AlfredoSystems/NoU3-Hardware/3dmodels/ESP32-S3-MINI-1.step

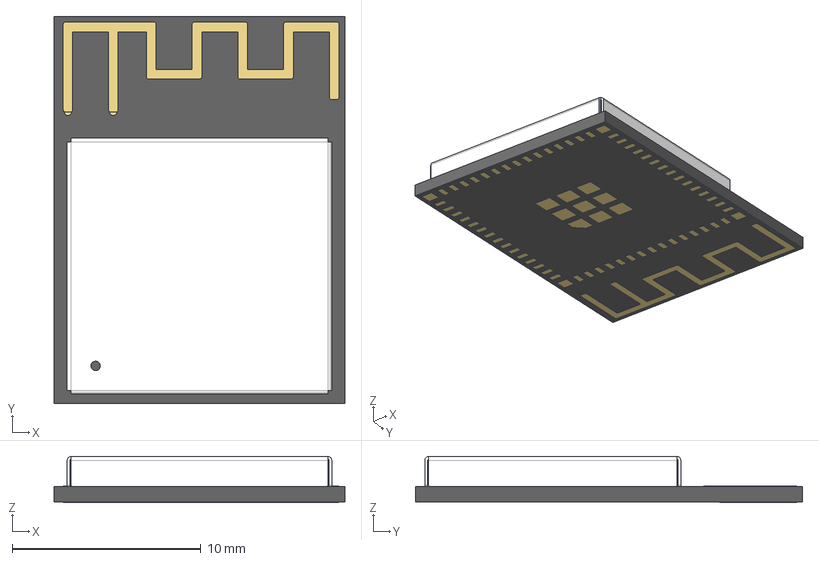
[picture p1: CAD file, 2026-11-02]
3dmodels/ESP32-S3-MINI-1.step
15.4 x 20.5 x 2.44 mm
uid__2489
C0201_20210301.xtd x 14
L0201_20210301.xtd x 3
R0201_20210301.xtd x 3
C0402_20210301.xtd
ESP32-S3_20210301.xtd
DFN1006.xtd
XTAL3225_20210301.xtd
Imported
MINI-ANT-TYPE-S-H_t
MINI-ANT-TYPE-S-H_b
ESP32-S3-S2-MINI-solder_pad
ShieldBox_ESP32-S2-MINI-1_V1.1_20231127
