AlfredoSystems/NoU3-Hardware/NoU3-Media/NoU3.pdf

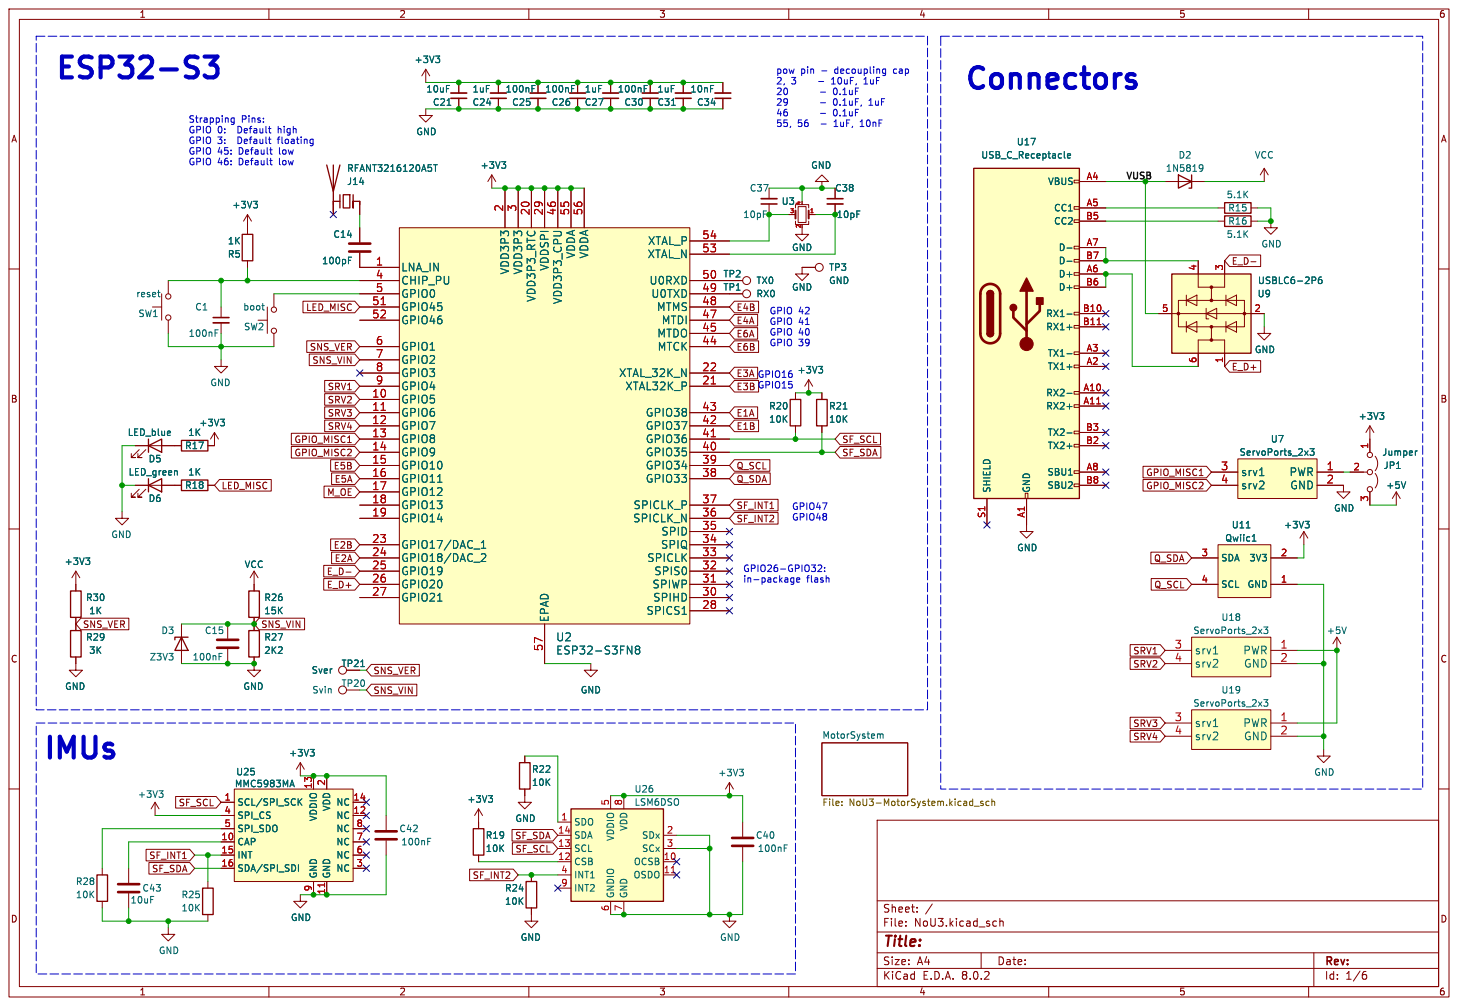
[picture p2: page 1]

3 SPIHD 30 SPIWP 31 SPIS0 32 SPICLK 33 SPIQ 34 SPID 35 SPICLK_N 36 SPICLK_P 37 GPIO33 38 GPIO34 39 CHIP_PU 4 GPIO35 40 GPIO36 41 GPIO37 42 GPIO38 43 MTCK 44 MTDO 45 VDD3P3_CPU 46 MTDI 47 MTMS 48 U0TXD 49 GPIO0 5 U0RXD 50 GPIO45 51 GPIO46 52 XTAL_N 53 XTAL_P 54 VDDA 55 VDDA 56 EPAD 57 GPIO1 6 GPIO2 7 GPIO3 8 GPIO4 9 C14

3 SPIHD 30 SPIWP 31 SPIS0 32 SPICLK 33 SPIQ 34 SPID 35 SPICLK_N 36 SPICLK_P 37 GPIO33 38 GPIO34 39 CHIP_PU 4 GPIO35 40 GPIO36 41 GPIO37 42 GPIO38 43 MTCK 44 MTDO 45 VDD3P3_CPU 46 MTDI 47 MTMS 48 U0TXD 49 GPIO0 5 U0RXD 50 GPIO45 51 GPIO46 52 XTAL_N 53 XTAL_P 54 VDDA 55 VDDA 56 EPAD 57 GPIO1 6 GPIO2 7 GPIO3 8 GPIO4 9 U2ESP32-S3FN8

put buttons in better spot GPIO26-GPIO32:

Id: 1/6 Title: File: NoU3.kicad_sch Sheet: / MotorSystem

2 NC 3 SPI_CS 4 SPI_SDO 5 NC 6 NC 7 NC 8 GND

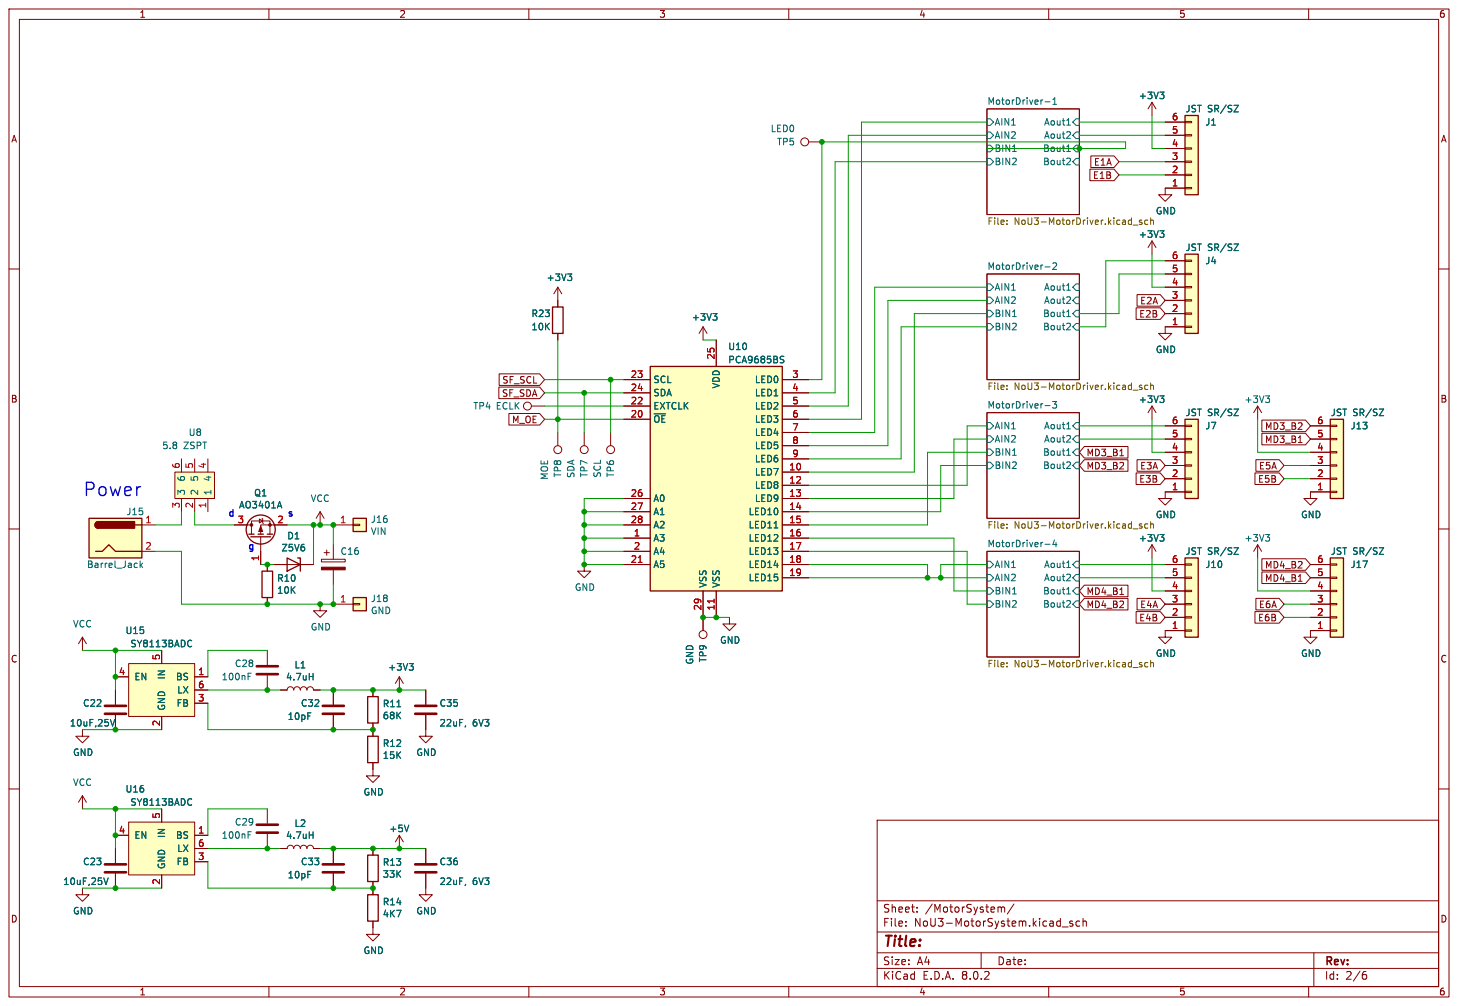
[picture p3: page 2]

JST SR/SZ SDA TP7 R23

JST SR/SZ GND GND

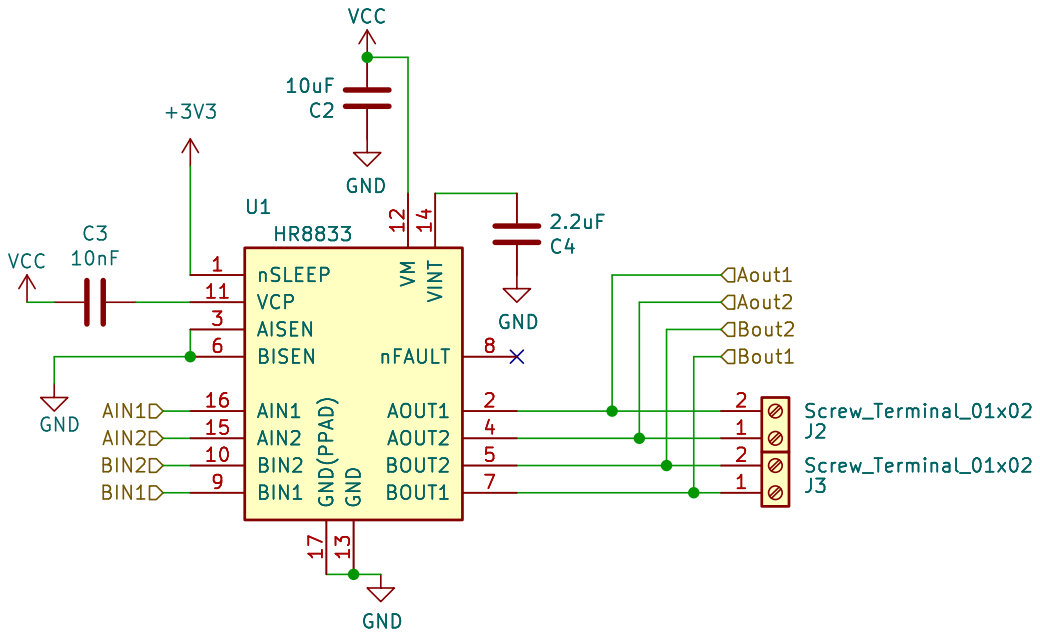
[picture p4: page 3]

1 1
2 2

Id: 3/6 Title: File: NoU3-MotorDriver.kicad_sch Sheet: /MotorSystem/MotorDriver-1/

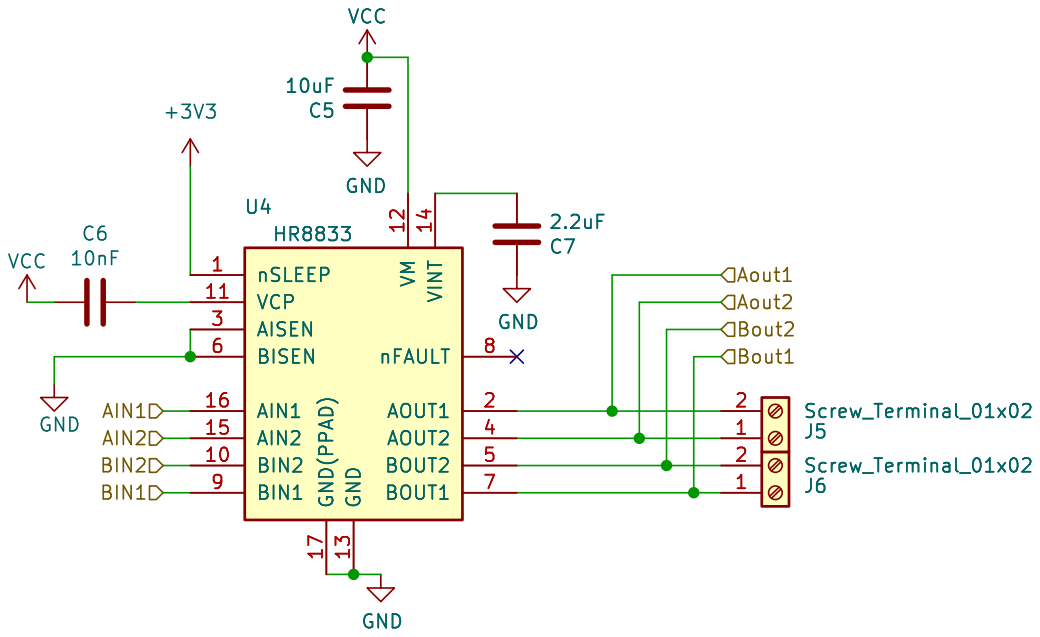
[picture p5: page 4]

1 1
2 2

Id: 4/6 Title: File: NoU3-MotorDriver.kicad_sch Sheet: /MotorSystem/MotorDriver-2/

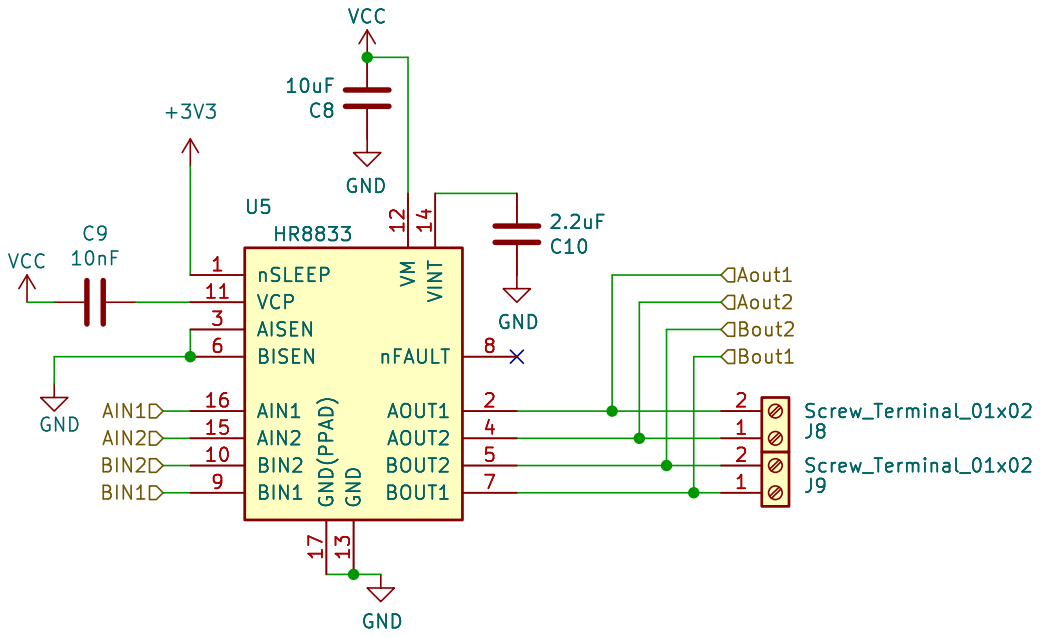
[picture p6: page 5]

1 1
2 2

Id: 5/6 Title: File: NoU3-MotorDriver.kicad_sch Sheet: /MotorSystem/MotorDriver-3/

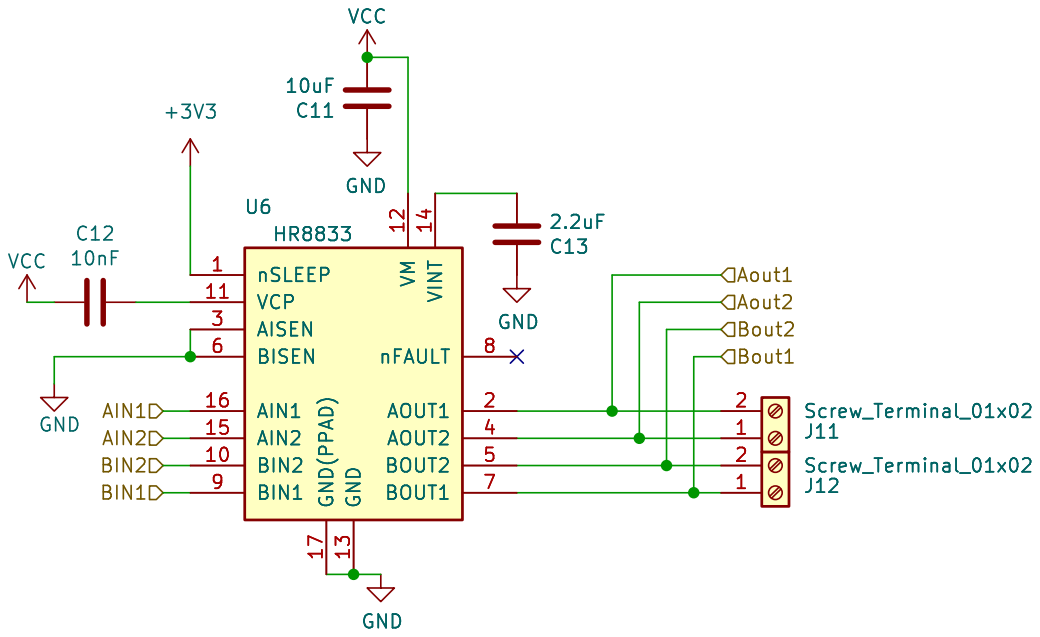
[picture p7: page 6]

1 1
2 2

Id: 6/6 Title: File: NoU3-MotorDriver.kicad_sch Sheet: /MotorSystem/MotorDriver-4/
