AlfredoSystems/NoU3-Hardware/(commit log)

2023-03-30 NoU3 initial commit and first board revision
    [NoU3-MotorDriver.kicad_sch, NoU3.kicad_pcb, NoU3.kicad_sch]
2023-07-27 locked in mag and 6dof sensor for this rev
    [NoU3.kicad_sch]
2023-07-27 vin sns and version sns dividers
    [NoU3.kicad_sch]
2023-07-29 finished main changes, just need to route now
    [NoU3-MotorDriver.kicad_sch, NoU3.kicad_pcb, NoU3.kicad_sch]
2023-07-30 routing half finished
    [NoU3.kicad_pcb, NoU3.kicad_sch]
2023-07-30 finished routing, ran DRC, fixed all the important DRC errors
    [NoU3.kicad_pcb, NoU3.kicad_sch]
2023-08-09 NoU3 as ordered 8/7/23
    [BOM-NoU3.csv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]
2023-10-09 updated date
    [NoU3.kicad_pcb]
2023-12-11 added jst CAD
    [BM06B-SRSS-TB.STEP, NoU3.kicad_pcb, NoU3.kicad_sch]
2024-04-27 updated todo
    [NoU3.kicad_sch]
2024-05-06 updated notes
    [NoU3.kicad_sch]
2024-05-15 initial V3.2 changes
    [NoU3-MotorDriver.kicad_sch, NoU3.kicad_pcb, NoU3.kicad_sch]
2024-05-16 order candidate, layout complete
    [NoU3-MotorDriver.kicad_sch, NoU3.kicad_pcb, NoU3.kicad_sch]
2024-05-30 used a different fabrication tool
    [BOM-NoU3.csv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]
2024-07-02 Ordered NoU3.3 and 3.4 lite
    [BM06B-SRSS-TB.STEP, NoU3-Lite-MotorDriver.kicad_sch, NoU3-Lite.kicad_pcb, NoU3-Lite.kicad_sch, NoU3.kicad_pcb, NoU3.kicad_sch, bom.csv, designators.csv]
2024-08-16 rule and schematic tweaks
    [NoU3.kicad_pcb]
2024-10-03 Schematic cleanup and plotted PDF
    [NoU3-MotorDriver.kicad_sch, NoU3-MotorSystem.kicad_sch, NoU3.kicad_pcb, NoU3.kicad_sch]
2025-04-03 updated labels
    [NoU3-MotorDriver.kicad_sch, NoU3-MotorSystem.kicad_sch, NoU3.kicad_pcb, bom.csv]
2025-04-10 commit before updating to kicad 9
    [NoU3.kicad_pcb, bom.csv, designators.csv, positions.csv]
2025-04-10 updated for kicad 9
    [NoU3-MotorDriver.kicad_sch, NoU3-MotorSystem.kicad_sch, NoU3.kicad_sch]
2025-04-28 panalized for latest order
    [NoU3.kicad_pcb, bom.csv, designators.csv, positions.csv]
2025-07-18 Update wiring and remove unused junctions in schematic
    [NoU3-MotorSystem.kicad_sch]
2025-10-22 first commit for V3.4 changes
    [NoU3.kicad_pcb, NoU3.kicad_sch]
2025-11-05 bumped version to NoU3.5
    [NoU3-MotorSystem.kicad_sch, NoU3.kicad_pcb, NoU3.kicad_sch, bom.csv, designators.csv, positions.csv]
2025-11-05 removed mag sensor, improved regulator resistor values
    [NoU3-MotorSystem.kicad_sch, NoU3.kicad_pcb, NoU3.kicad_sch]
2025-11-06 added 7th encoder, 2nd 220uf cap
    [NoU3-MotorSystem.kicad_sch, NoU3.kicad_pcb, NoU3.kicad_sch, bom.csv, designators.csv, positions.csv]
2025-11-06 NoU3.5s as ordered 11/6/25
    [NoU3-MotorSystem.kicad_sch, NoU3.kicad_pcb, NoU3.kicad_sch, bom.csv, designators.csv, positions.csv]
2025-11-25 first commit for NoU3.6
    [NoU3.kicad_pcb, NoU3.kicad_sch]
2025-11-26 Update LSM6DS3TR-C part and add PCB silk circle
    Changed the schematic part value, datasheet, and LCSC code from LSM6DSDTR to LSM6DS3TR-C. Added a new circle to the F.SilkS layer in the PCB. Removed the auto-saved files reference.
    [NoU3.kicad_pcb, NoU3.kicad_sch]
2025-11-26 Fixed polarity convention for encoder port 1
    [NoU3.kicad_pcb]
2025-12-02 Swap positions of MD2_A1 and MD2_A2 labels
    [NoU3-MotorSystem.kicad_sch]
2026-03-25 Adjust component positions, silkscreen and traces
    [NoU3.kicad_pcb, NoU3.kicad_sch]
2026-07-22 Updated to KiCAD 10.0
    [NoU3-MotorDriver.kicad_sch, NoU3-MotorSystem.kicad_sch, NoU3.kicad_pcb, NoU3.kicad_sch]
2026-09-29 Update .gitignore and untrack lock files and fab backups
    Ignore KiCad local history (.history/), lock files (*.lck), fab plugin backup zips (production*/backups/) and OS junk. Fix the #auto_saved_files# rule, which git was reading as a comment.
2026-10-20 updated footprints
2026-10-21 cleaned up JSTs on motor driver sheet
2026-10-21 Reroute PCB connections and adjust DRC rules
    Add and revise PCB routing for several connector and component nets, including repositioning U9. Ignore silkscreen clearance and overlap violations, and update schematic notes.
2026-10-23 PY32F030K28U6TR motor controller chip
2026-10-29 motor driver footprints
2026-11-02 switch to ESP32-S3-MINI
2026-11-11 trace width and via fixes for current levels
