AlfredoSystems/NoU3-Hardware/NoU3.kicad_pcb

## KiCad design NoU3.kicad_pcb (2026-11-11)

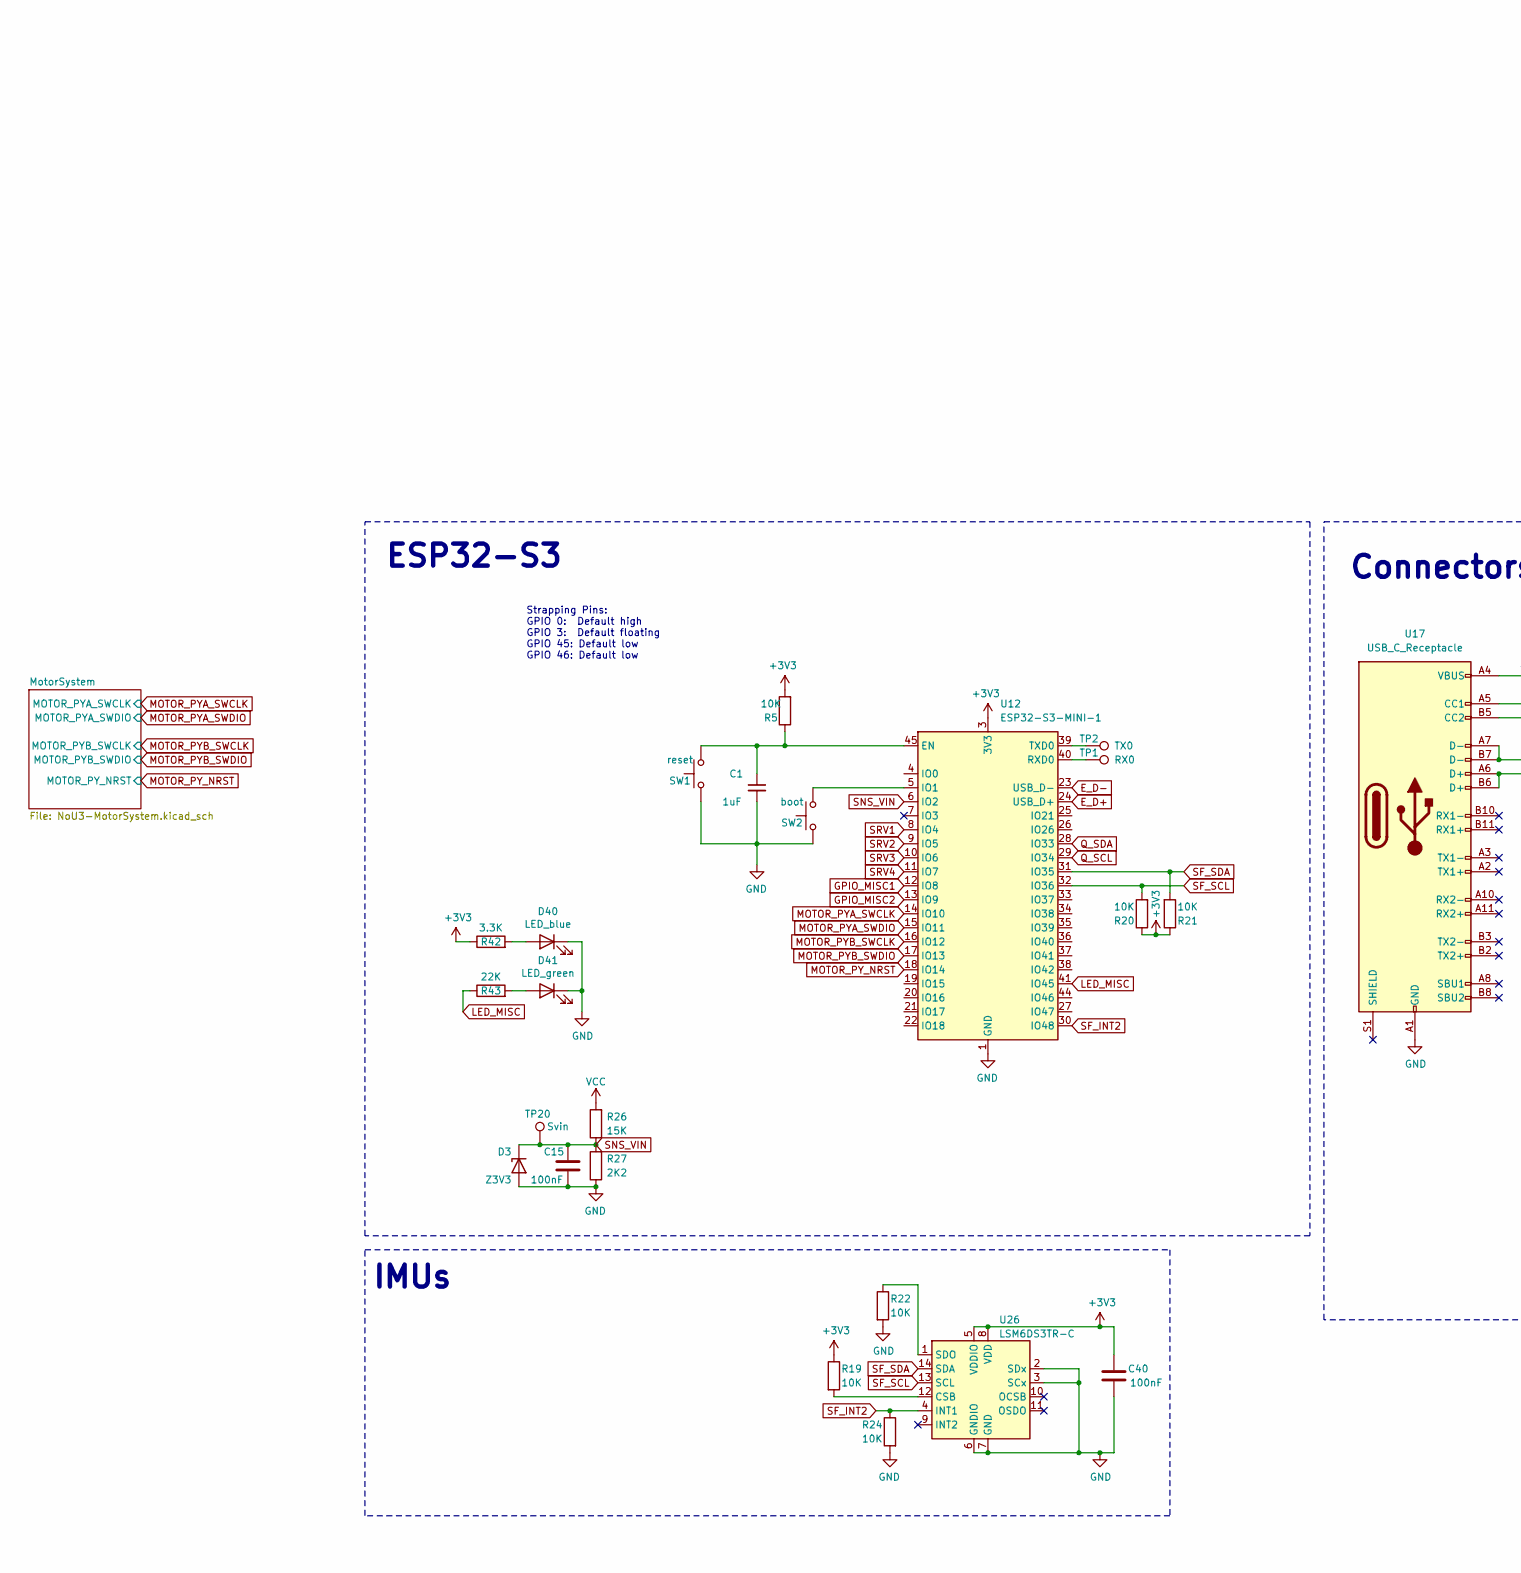
[picture p1: schematic NoU3.kicad_sch, part in row 1, column 1]

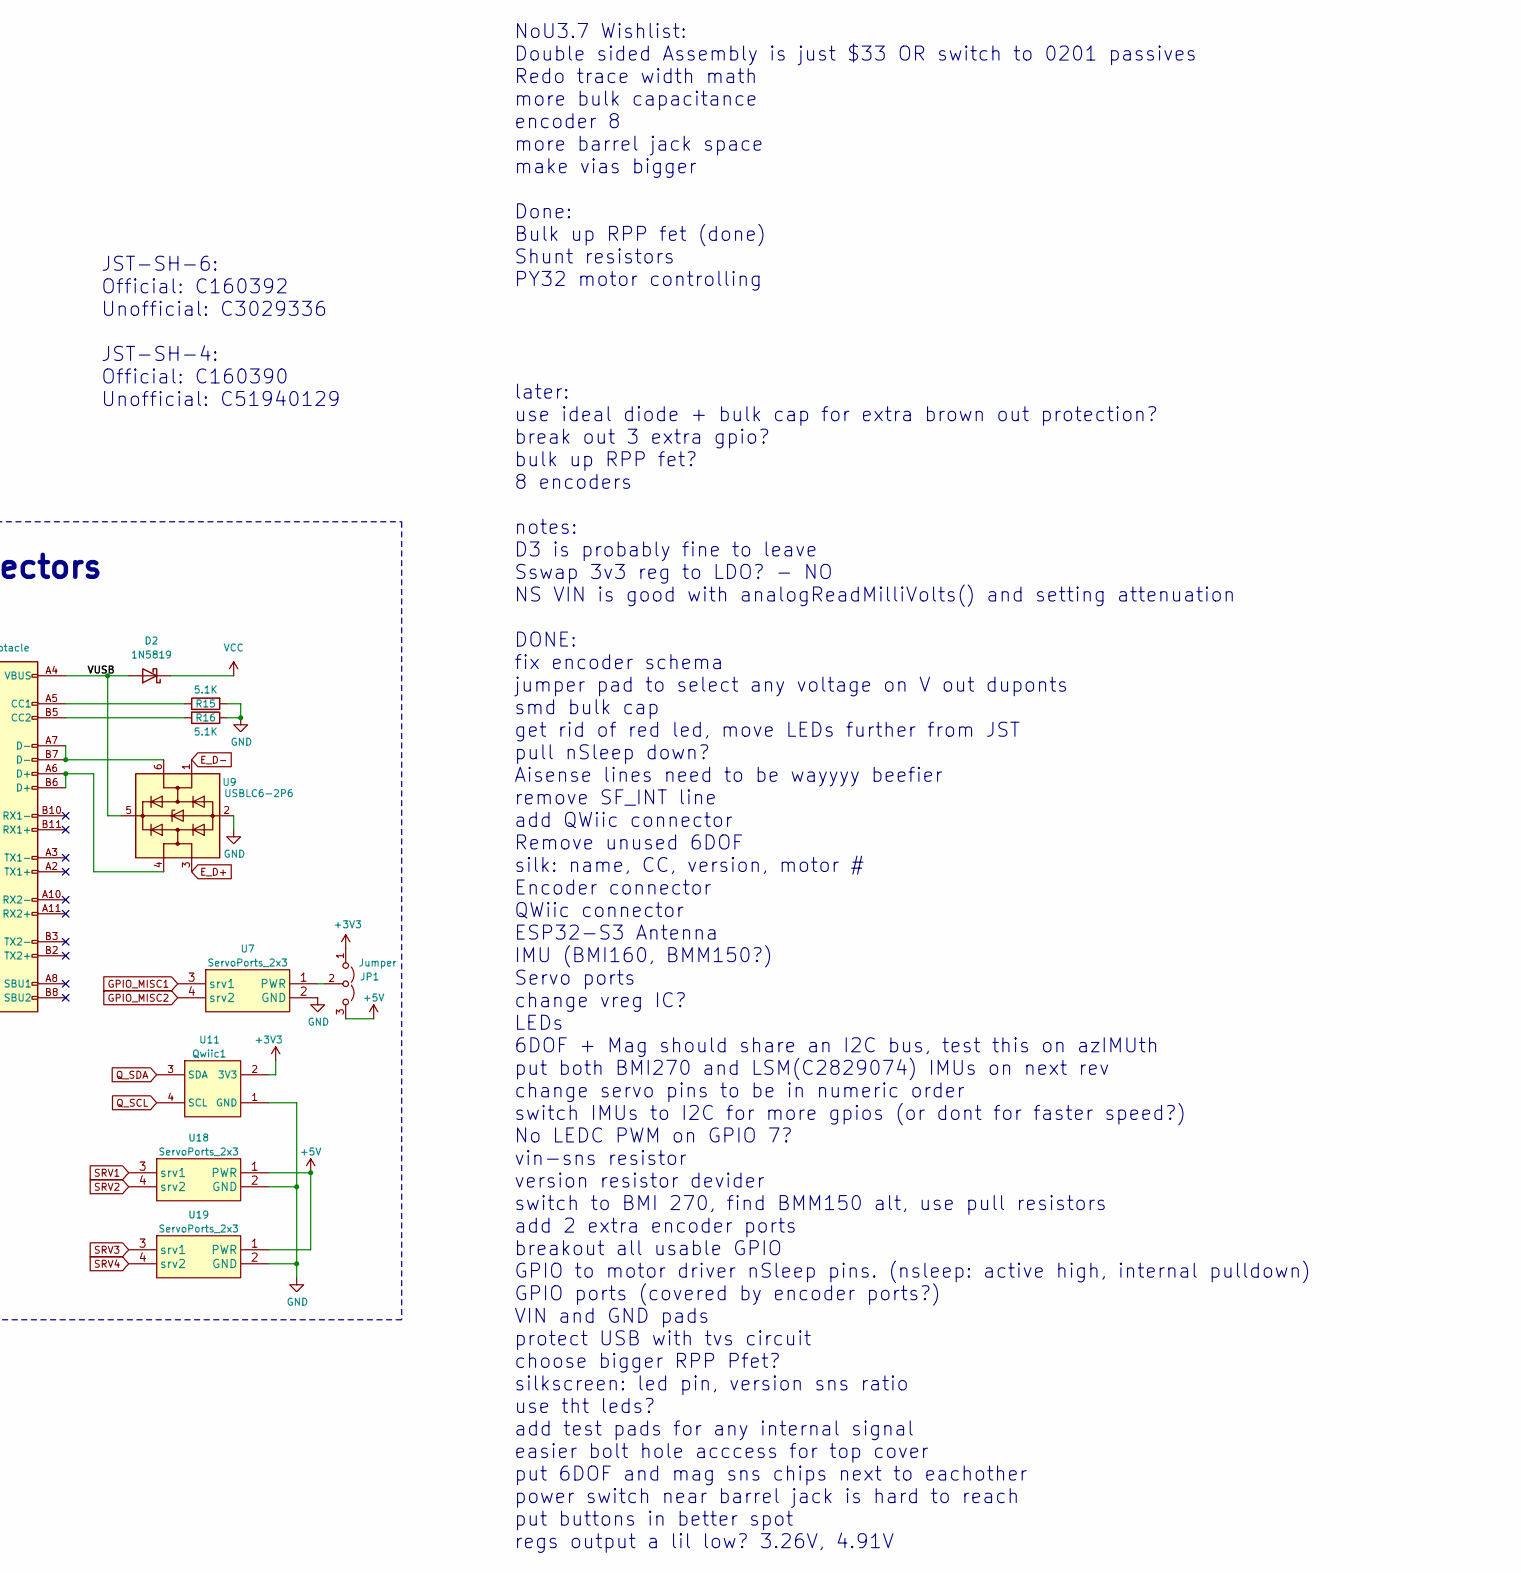
[picture p2: schematic NoU3.kicad_sch, part in row 1, column 2]

Parts:
C1: 1uF; C_0402_1005Metric; LCSC C52923
C15, C40: 100nF; C_0402_1005Metric; LCSC C307331
D2: 1N5819; D_SOD-323; LCSC C191023
D3: Z3V3; D_SOD-323; LCSC C75073
D40: LED_blue; LED_0402_1005Metric; LCSC C130724
D41: LED_green; LED_0402_1005Metric; LCSC C965793
JP1: Jumper; SolderJumper-3-Small
R5, R19, R20, R21, R22, R24: 10K; R_0402_1005Metric; LCSC C25744
R15, R16: 5.1K; R_0402_1005Metric; LCSC C25905
R26: 15K; R_0402_1005Metric; LCSC C25756
R27: 2K2; R_0402_1005Metric; LCSC C25879
R42: 3.3K; R_0402_1005Metric
R43: 22K; R_0402_1005Metric
SW1: reset; Button_SKRKAEE020; LCSC C115357
SW2: boot; Button_SKRKAEE020; LCSC C115357
TP1: RX0; PogoPad1
TP2: TX0; PogoPad1
TP20: Svin; PogoPad1
U7, U18, U19: ServoPorts_2x3; LCSC C5116479
U9: USBLC6-2P6; SOT-666; LCSC C2827693
U11: Qwiic1; JST_SH_BM04B-SRSS-TB_1x04-1MP_P1.00mm_Vertical; LCSC C51940129
U12: ESP32-S3-MINI-1; ESP32-S2-MINI-1; LCSC C2913206
U17: USB_C_Receptacle; USB_TYPE-C-31-M-12; LCSC C165948
U26: LSM6DS3TR-C; Bosch_LGA-14_3x2.5mm_P0.5mm; LCSC C967633

Connections:
+3V3: C40.1, JP1.1 (A), R5.2, R19.1, R20.1, R21.1, R42.1, U11.2 (3V3), U12.3 (3V3), U26.5 (VDDIO), U26.8 (VDD); also elsewhere on the board
+5V: JP1.3 (B), U18.1 (PWR), U19.1 (PWR); also elsewhere on the board
/VUSB: D2.2 (A), U9.5 (VBUS), U17.A4 (VBUS), U17.A9 (VBUS), U17.B4 (VBUS), U17.B9 (VBUS)
E_D+: U9.3 (I/O2), U12.24 (USB_D+)
E_D-: U9.1 (I/O1), U12.23 (USB_D-)
GND: C1.2, C15.2, C40.2, D3.2 (A), D40.1 (K), D41.1 (K), R15.2, R16.1, R22.2, R24.2, R27.1, SW1.2, SW2.2, U7.2 (GND), U9.2 (GND), U11.1 (GND), U12.1 (GND), U12.2 (GND), U12.42 (GND), U12.43 (GND), U12.46 (GND), U12.47 (GND), U12.48 (GND), U12.49 (GND), U12.50 (GND), U12.51 (GND), U12.52 (GND), U12.53 (GND), U12.54 (GND), U12.55 (GND), U12.56 (GND), U12.57 (GND), U12.58 (GND), U12.59 (GND), U12.60 (GND), U12.61 (GND), U12.62 (GND), U12.63 (GND), U12.64 (GND), U12.65 (GND), U17.A1 (GND), U17.A12 (GND), U17.B1 (GND), U17.B12 (GND), U18.2 (GND), U19.2 (GND), U26.2 (SDx), U26.3 (SCx), U26.6 (GNDIO), U26.7 (GND); also elsewhere on the board
GPIO_MISC1: U7.3 (srv1), U12.12 (IO8)
GPIO_MISC2: U7.4 (srv2), U12.13 (IO9)
LED_MISC: R43.1, U12.41 (IO45)
MOTOR_PYA_SWCLK: U12.14 (IO10); also elsewhere on the board
MOTOR_PYA_SWDIO: U12.15 (IO11); also elsewhere on the board
MOTOR_PYB_SWCLK: U12.16 (IO12); also elsewhere on the board
MOTOR_PYB_SWDIO: U12.17 (IO13); also elsewhere on the board
MOTOR_PY_NRST: U12.18 (IO14); also elsewhere on the board
unnamed: D40.2 (A), R42.2
unnamed: D41.2 (A), R43.2
unnamed: JP1.2 (C), U7.1 (PWR)
unnamed: C1.1, R5.1, SW1.1, U12.45 (EN)
unnamed: SW2.1, U12.5 (IO1)
unnamed: TP1.1 (1_1), U12.40 (RXD0)
unnamed: TP2.1 (1_1), U12.39 (TXD0)
unnamed: R15.1, U17.A5 (CC1)
unnamed: R16.2, U17.B5 (CC2)
unnamed: U9.4 (I/O2), U17.A6 (D+), U17.B6 (D+)
unnamed: U9.6 (I/O1), U17.A7 (D-), U17.B7 (D-)
unnamed: R19.2, U26.12 (CSB)
unnamed: R22.1, U26.1 (SDO)
Q_SCL: U11.4 (SCL), U12.29 (IO34)
Q_SDA: U11.3 (SDA), U12.28 (IO33)
SF_INT2: R24.1, U12.30 (IO48), U26.4 (INT1)
SF_SCL: R20.2, U12.32 (IO36), U26.13 (SCL)
SF_SDA: R21.2, U12.31 (IO35), U26.14 (SDA)
SNS_VIN: C15.1, D3.1 (K), R26.1, R27.2, TP20.1 (1_1), U12.6 (IO2)
SRV1: U12.8 (IO4), U18.3 (srv1)
SRV2: U12.9 (IO5), U18.4 (srv2)
SRV3: U12.10 (IO6), U19.3 (srv1)
SRV4: U12.11 (IO7), U19.4 (srv2)
VCC: D2.1 (K), R26.2; also elsewhere on the board

Notes on the sheet:
IMUs
Strapping Pins: GPIO 0: Default high GPIO 3: Default floating GPIO 45: Default low GPIO 46: Default low
NoU3.7 Wishlist: Double sided Assembly is just $33 OR switch to 0201 passives Redo trace width math more bulk capacitance encoder 8 more barrel jack space make vias bigger Done: Bulk up RPP fet (done) Shunt resistors PY32 motor controlling later: use ideal diode + bulk cap for extra brown out prote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
Connectors
ESP32-S3
JST-SH-6: Official: C160392 Unofficial: C3029336 JST-SH-4: Official: C160390 Unofficial: C51940129

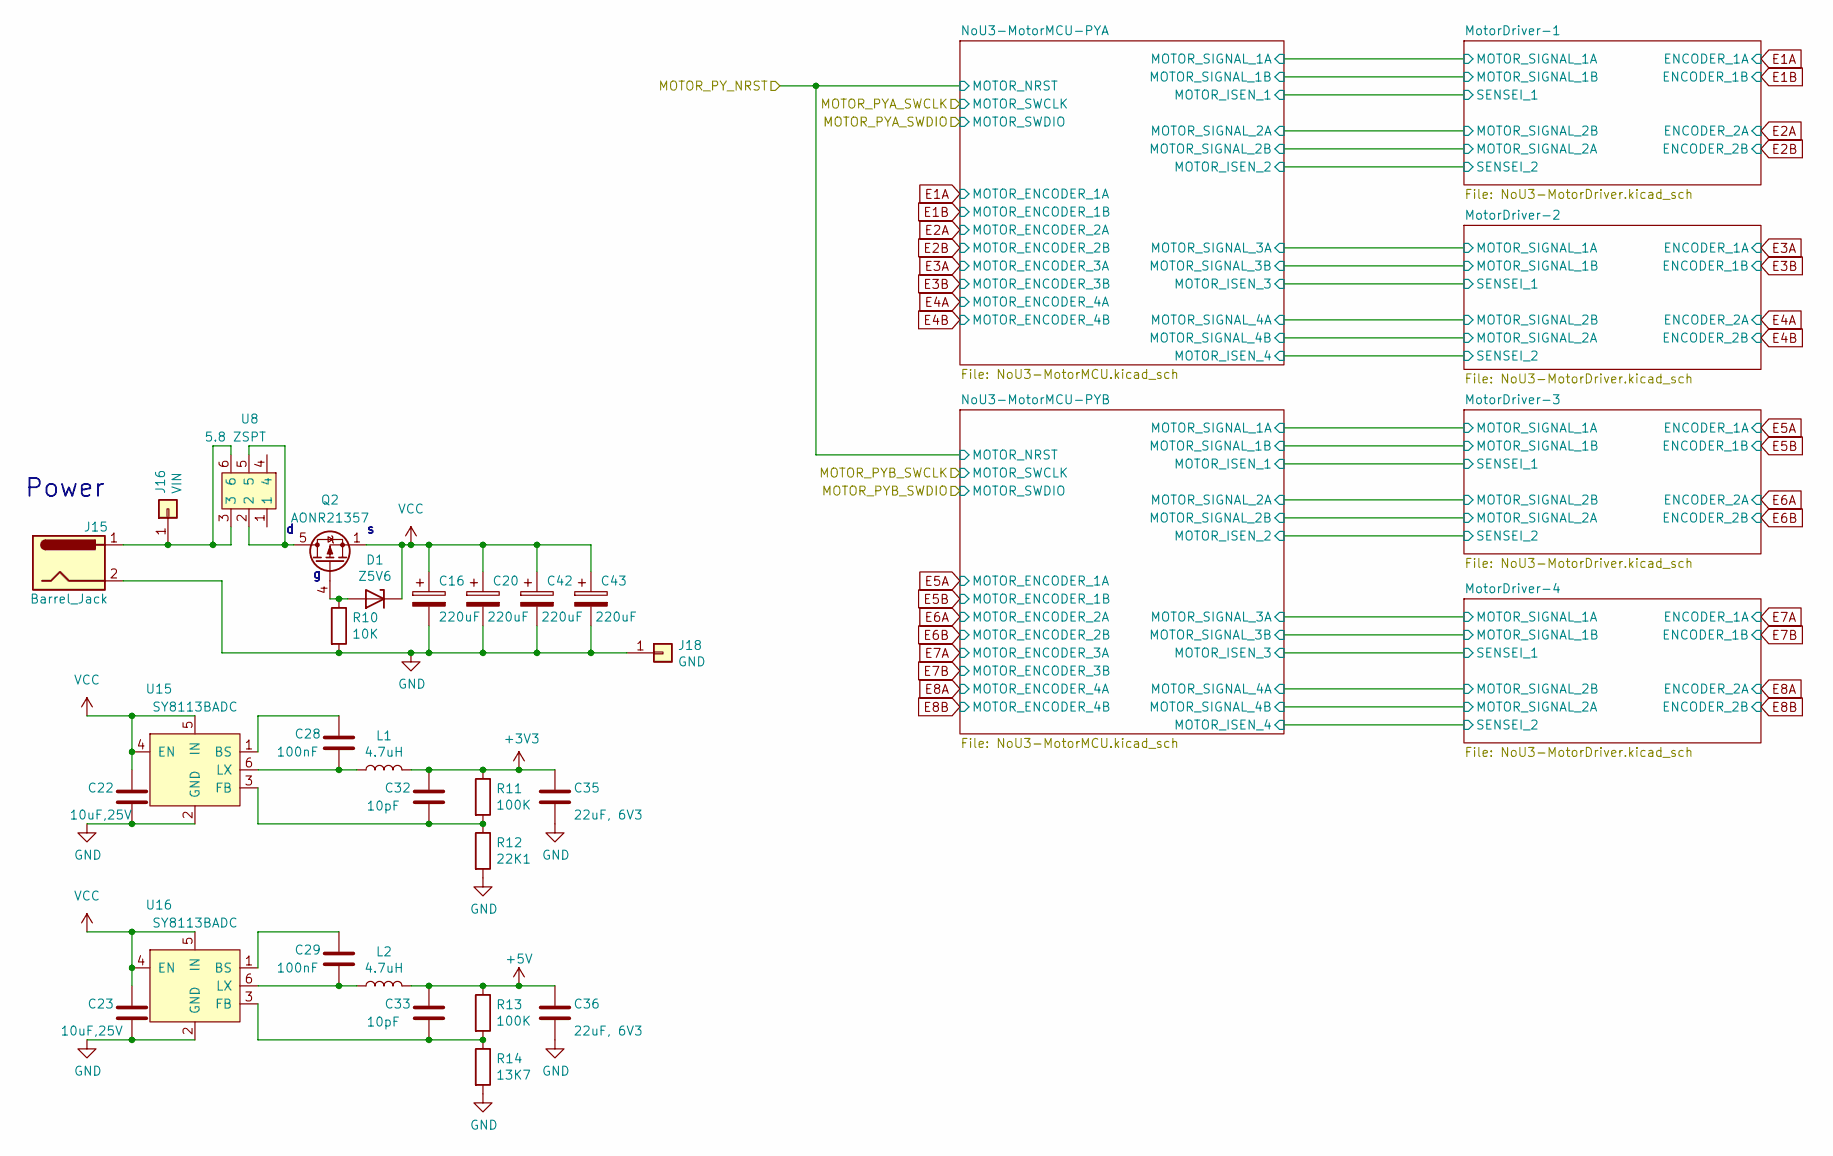
[picture p3: schematic NoU3-MotorSystem.kicad_sch]

Parts:
C16, C20, C42, C43: 220uF; CP_Elec_6.3x7.7_slim; LCSC C4747974
C22, C23: 10uF,25V; C_0603_1608Metric; LCSC C96446
C28, C29: 100nF; C_0402_1005Metric; LCSC C307331
C32, C33: 10pF; C_0402_1005Metric; LCSC C32949
C35, C36: 22uF, 6V3; C_0603_1608Metric; LCSC C59461
D1: Z5V6; D_SOD-323; LCSC C22612
J15: Barrel_Jack; DC-005C_1; LCSC C84007
J16: VIN; PinSocket_1x01_P2.54mm_Vertical
J18: GND; PinSocket_1x01_P2.54mm_Vertical
L1, L2: 4.7uH; LVF252A12; LCSC C88528
Q2: AONR21357; DFN-8-1EP_3x3mm_P0.65mm_EP1.55x2.4mm; LCSC C431196
R10: 10K; R_0402_1005Metric; LCSC C25744
R11, R13: 100K; R_0402_1005Metric; LCSC C25741
R12: 22K1; R_0402_1005Metric; LCSC C163478
R14: 13K7; R_0402_1005Metric; LCSC C25854
U8: 5.8 ZSPT; XKB5858-Z-75; LCSC C963201
U15, U16: SY8113BADC; TSOT-23-6; LCSC C78989

Connections:
+3V3: C32.1, C35.1, L1.2, R11.1; also elsewhere on the board
+5V: C33.1, C36.1, L2.2, R13.1; also elsewhere on the board
GND: C16.2, C20.2, C22.2, C23.2, C35.2, C36.2, C42.2, C43.2, J15.2, J18.1 (Pin_1_1), R10.2, R12.2, R14.2, U15.2 (GND), U16.2 (GND); also elsewhere on the board
unnamed: D1.2 (A), Q2.4 (G), R10.1
unnamed: J15.1, J16.1 (Pin_1_1), U8.3, U8.6
unnamed: Q2.5 (D), Q2.6 (D), Q2.7 (D), Q2.8 (D), Q2.9 (D), U8.2, U8.5
unnamed: C28.1, U15.1 (BS)
unnamed: C32.2, R11.2, R12.1, U15.3 (FB)
unnamed: C28.2, L1.1, U15.6 (LX)
unnamed: C29.1, U16.1 (BS)
unnamed: C33.2, R13.2, R14.1, U16.3 (FB)
unnamed: C29.2, L2.1, U16.6 (LX)
VCC: C16.1, C20.1, C22.1, C23.1, C42.1, C43.1, D1.1 (K), Q2.1 (S), Q2.2 (S), Q2.3 (S), U15.4 (EN), U15.5 (IN), U16.4 (EN), U16.5 (IN); also elsewhere on the board

Notes on the sheet:
Power

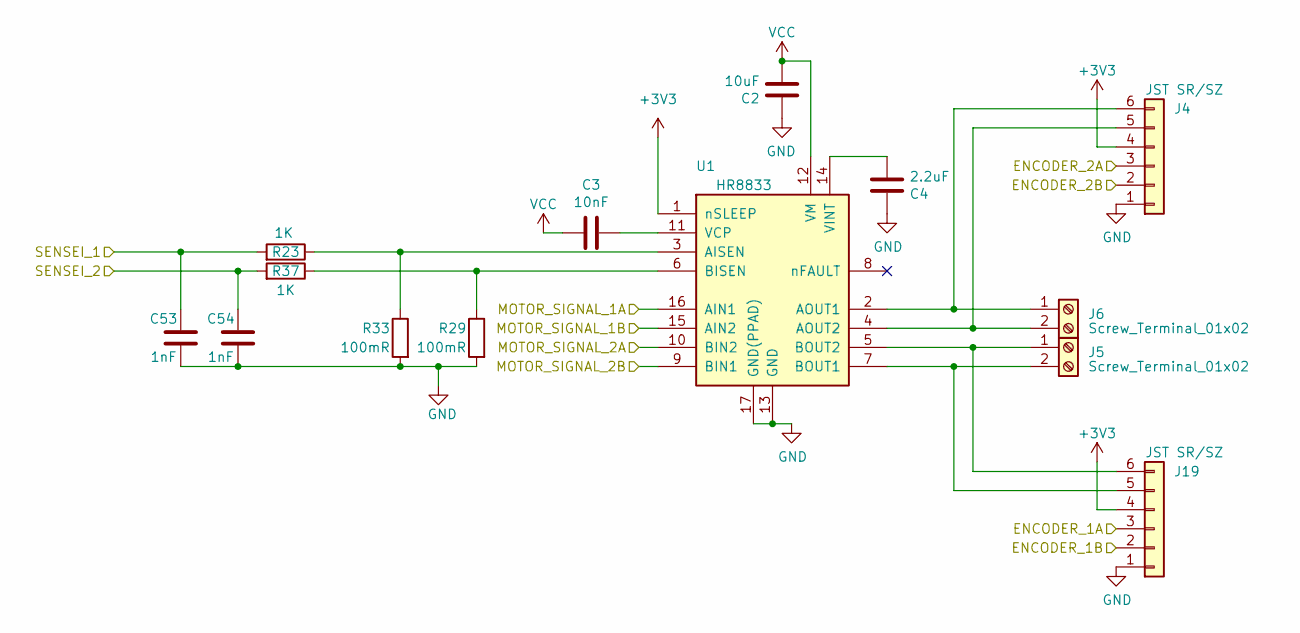
[picture p4: schematic NoU3-MotorDriver.kicad_sch]

Parts:
C2: 10uF; C_0805_2012Metric; LCSC C15850
C3: 10nF; C_0402_1005Metric; LCSC C15195
C4: 2.2uF; C_0402_1005Metric; LCSC C12530
C53, C54: 1nF; C_0402_1005Metric; LCSC C1523
J4, J19: JST SR/SZ; JST_SH_1x06_Vertical; LCSC C3029336
J5, J6: Screw_Terminal_01x02; TerminalBlock_Ningbo_2P_5mm; LCSC C557646
R23, R37: 1K; R_0402_1005Metric; LCSC C11702
R29, R33: 100mR; R_0805_2012Metric; LCSC C327057
U1: HR8833; HR8833-0.6mm; LCSC C128666

Connections:
+3V3: J4.4, J19.4, U1.1 (nSLEEP); also elsewhere on the board
/MotorSystem/MotorDriver-1/MOTOR_SIGNAL_1A: U1.16 (AIN1); also elsewhere on the board
/MotorSystem/MotorDriver-1/MOTOR_SIGNAL_1B: U1.15 (AIN2); also elsewhere on the board
/MotorSystem/MotorDriver-1/MOTOR_SIGNAL_2A: U1.10 (BIN2); also elsewhere on the board
/MotorSystem/MotorDriver-1/MOTOR_SIGNAL_2B: U1.9 (BIN1); also elsewhere on the board
/MotorSystem/MotorDriver-1/SENSEI_1: C53.1, R23.2; also elsewhere on the board
/MotorSystem/MotorDriver-1/SENSEI_2: C54.1, R37.2; also elsewhere on the board
E1A: J19.3; also elsewhere on the board
E1B: J19.2; also elsewhere on the board
E2A: J4.3; also elsewhere on the board
E2B: J4.2; also elsewhere on the board
GND: C2.2, C4.2, C53.2, C54.2, J4.1, J19.1, R29.2, R33.2, U1.13 (GND), U1.17 (GND(PPAD)); also elsewhere on the board
unnamed: J4.5, J6.2, U1.4 (AOUT2)
unnamed: J4.6, J6.1, U1.2 (AOUT1)
unnamed: J5.2, J19.5, U1.7 (BOUT1)
unnamed: J5.1, J19.6, U1.5 (BOUT2)
unnamed: R23.1, R33.1, U1.3 (AISEN)
unnamed: R29.1, R37.1, U1.6 (BISEN)
unnamed: C3.2, U1.11 (VCP)
unnamed: C4.1, U1.14 (VINT)
VCC: C2.1, C3.1, U1.12 (VM); also elsewhere on the board

Parts of its further copies:
C5, C8, C11: 10uF; C_0805_2012Metric; LCSC C15850
C6, C9, C12: 10nF; C_0402_1005Metric; LCSC C15195
C7, C10, C13: 2.2uF; C_0402_1005Metric; LCSC C12530
C49, C50, C55, C56, C59, C60: 1nF; C_0402_1005Metric; LCSC C1523
J1, J7, J10, J13, J17, J20: JST SR/SZ; JST_SH_1x06_Vertical; LCSC C3029336
J2, J3, J8, J9, J11, J12: Screw_Terminal_01x02; TerminalBlock_Ningbo_2P_5mm; LCSC C557646
R30, R31, R32, R34, R35, R36: 100mR; R_0805_2012Metric; LCSC C327057
R40, R41, R44, R45, R48, R49: 1K; R_0402_1005Metric; LCSC C11702
U4, U5, U6: HR8833; HR8833-0.6mm; LCSC C128666

Connections of its further copies:
+3V3: J1.4, J7.4, J10.4, J13.4, J17.4, J20.4, U4.1 (nSLEEP), U5.1 (nSLEEP), U6.1 (nSLEEP); also elsewhere on the board
/MotorSystem/MotorDriver-2/MOTOR_SIGNAL_1A: U4.16 (AIN1); also elsewhere on the board
/MotorSystem/MotorDriver-2/MOTOR_SIGNAL_1B: U4.15 (AIN2); also elsewhere on the board
/MotorSystem/MotorDriver-2/MOTOR_SIGNAL_2A: U4.10 (BIN2); also elsewhere on the board
/MotorSystem/MotorDriver-2/MOTOR_SIGNAL_2B: U4.9 (BIN1); also elsewhere on the board
/MotorSystem/MotorDriver-2/SENSEI_1: C55.1, R40.2; also elsewhere on the board
/MotorSystem/MotorDriver-2/SENSEI_2: C56.1, R41.2; also elsewhere on the board
/MotorSystem/MotorDriver-3/MOTOR_SIGNAL_1A: U5.16 (AIN1); also elsewhere on the board
/MotorSystem/MotorDriver-3/MOTOR_SIGNAL_1B: U5.15 (AIN2); also elsewhere on the board
/MotorSystem/MotorDriver-3/MOTOR_SIGNAL_2A: U5.10 (BIN2); also elsewhere on the board
/MotorSystem/MotorDriver-3/MOTOR_SIGNAL_2B: U5.9 (BIN1); also elsewhere on the board
/MotorSystem/MotorDriver-3/SENSEI_1: C49.1, R44.2; also elsewhere on the board
/MotorSystem/MotorDriver-3/SENSEI_2: C50.1, R45.2; also elsewhere on the board
/MotorSystem/MotorDriver-4/MOTOR_SIGNAL_1A: U6.16 (AIN1); also elsewhere on the board
/MotorSystem/MotorDriver-4/MOTOR_SIGNAL_1B: U6.15 (AIN2); also elsewhere on the board
/MotorSystem/MotorDriver-4/MOTOR_SIGNAL_2A: U6.10 (BIN2); also elsewhere on the board
/MotorSystem/MotorDriver-4/MOTOR_SIGNAL_2B: U6.9 (BIN1); also elsewhere on the board
/MotorSystem/MotorDriver-4/SENSEI_1: C59.1, R48.2; also elsewhere on the board
/MotorSystem/MotorDriver-4/SENSEI_2: C60.1, R49.2; also elsewhere on the board
E3A: J7.3; also elsewhere on the board
E3B: J7.2; also elsewhere on the board
E4A: J13.3; also elsewhere on the board
E4B: J13.2; also elsewhere on the board
E5A: J10.3; also elsewhere on the board
E5B: J10.2; also elsewhere on the board
E6A: J17.3; also elsewhere on the board
E6B: J17.2; also elsewhere on the board
E7A: J1.3; also elsewhere on the board
E7B: J1.2; also elsewhere on the board
E8A: J20.3; also elsewhere on the board
E8B: J20.2; also elsewhere on the board
GND: C5.2, C7.2, C8.2, C10.2, C11.2, C13.2, C49.2, C50.2, C55.2, C56.2, C59.2, C60.2, J1.1, J7.1, J10.1, J13.1, J17.1, J20.1, R30.2, R31.2, R32.2, R34.2, R35.2, R36.2, U4.13 (GND), U4.17 (GND(PPAD)), U5.13 (GND), U5.17 (GND(PPAD)), U6.13 (GND), U6.17 (GND(PPAD)); also elsewhere on the board
unnamed: J1.5, J2.2, U6.7 (BOUT1)
unnamed: J1.6, J2.1, U6.5 (BOUT2)
unnamed: J7.5, J8.2, U4.7 (BOUT1)
unnamed: J7.6, J8.1, U4.5 (BOUT2)
unnamed: J10.5, J11.2, U5.7 (BOUT1)
unnamed: J10.6, J11.1, U5.5 (BOUT2)
unnamed: J12.1, J17.6, U5.2 (AOUT1)
unnamed: J12.2, J17.5, U5.4 (AOUT2)
unnamed: J9.2, J13.5, U4.4 (AOUT2)
unnamed: J9.1, J13.6, U4.2 (AOUT1)
unnamed: J3.2, J20.5, U6.4 (AOUT2)
unnamed: J3.1, J20.6, U6.2 (AOUT1)
unnamed: R34.1, R40.1, U4.3 (AISEN)
unnamed: R30.1, R41.1, U4.6 (BISEN)
unnamed: C6.2, U4.11 (VCP)
unnamed: C7.1, U4.14 (VINT)
unnamed: R35.1, R44.1, U5.3 (AISEN)
unnamed: R31.1, R45.1, U5.6 (BISEN)
unnamed: C9.2, U5.11 (VCP)
unnamed: C10.1, U5.14 (VINT)
unnamed: R36.1, R48.1, U6.3 (AISEN)
unnamed: R32.1, R49.1, U6.6 (BISEN)
unnamed: C12.2, U6.11 (VCP)
unnamed: C13.1, U6.14 (VINT)
VCC: C5.1, C6.1, C8.1, C9.1, C11.1, C12.1, U4.12 (VM), U5.12 (VM), U6.12 (VM); also elsewhere on the board

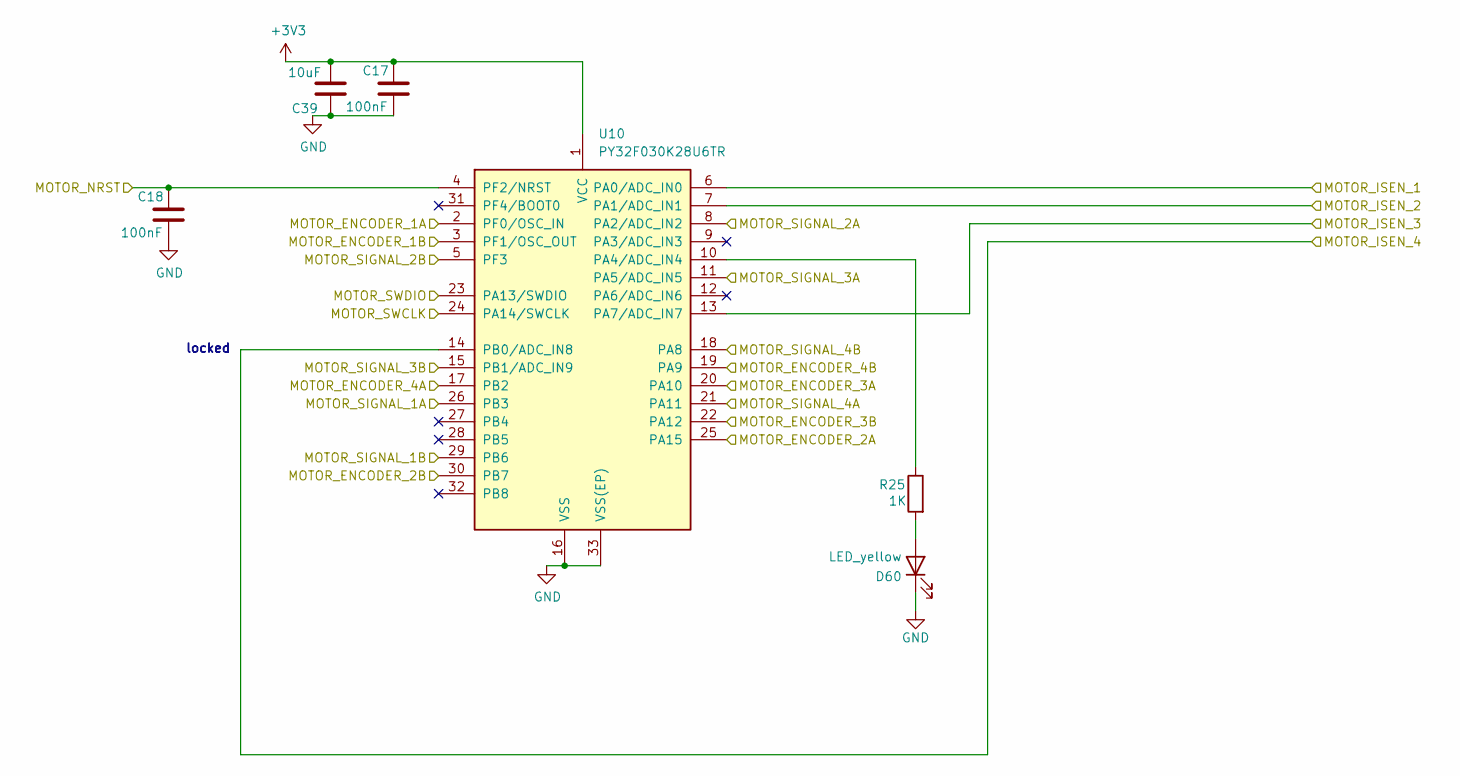
[picture p5: schematic NoU3-MotorMCU.kicad_sch]

Parts:
C17, C18: 100nF; C_0402_1005Metric; LCSC C307331
C39: 10uF; C_0402_1005Metric; LCSC C15525
D60: LED_yellow; LED_0402_1005Metric; LCSC C130721
R25: 1K; R_0402_1005Metric; LCSC C11702
U10: PY32F030K28U6TR; VQFN-32-1EP_5x5mm_P0.5mm_EP3.5x3.5mm; LCSC C3018718

Connections:
+3V3: C17.1, C39.2, U10.1 (VCC); also elsewhere on the board
/MotorSystem/MotorDriver-1/MOTOR_SIGNAL_1A: U10.26 (PB3); also elsewhere on the board
/MotorSystem/MotorDriver-1/MOTOR_SIGNAL_1B: U10.29 (PB6); also elsewhere on the board
/MotorSystem/MotorDriver-1/MOTOR_SIGNAL_2A: U10.5 (PF3); also elsewhere on the board
/MotorSystem/MotorDriver-1/MOTOR_SIGNAL_2B: U10.8 (PA2/ADC_IN2); also elsewhere on the board
/MotorSystem/MotorDriver-1/SENSEI_1: U10.6 (PA0/ADC_IN0); also elsewhere on the board
/MotorSystem/MotorDriver-1/SENSEI_2: U10.7 (PA1/ADC_IN1); also elsewhere on the board
/MotorSystem/MotorDriver-2/MOTOR_SIGNAL_1A: U10.11 (PA5/ADC_IN5); also elsewhere on the board
/MotorSystem/MotorDriver-2/MOTOR_SIGNAL_1B: U10.15 (PB1/ADC_IN9); also elsewhere on the board
/MotorSystem/MotorDriver-2/MOTOR_SIGNAL_2A: U10.18 (PA8); also elsewhere on the board
/MotorSystem/MotorDriver-2/MOTOR_SIGNAL_2B: U10.21 (PA11); also elsewhere on the board
/MotorSystem/MotorDriver-2/SENSEI_1: U10.13 (PA7/ADC_IN7); also elsewhere on the board
/MotorSystem/MotorDriver-2/SENSEI_2: U10.14 (PB0/ADC_IN8); also elsewhere on the board
E1A: U10.2 (PF0/OSC_IN); also elsewhere on the board
E1B: U10.3 (PF1/OSC_OUT); also elsewhere on the board
E2A: U10.25 (PA15); also elsewhere on the board
E2B: U10.30 (PB7); also elsewhere on the board
E3A: U10.20 (PA10); also elsewhere on the board
E3B: U10.22 (PA12); also elsewhere on the board
E4A: U10.17 (PB2); also elsewhere on the board
E4B: U10.19 (PA9); also elsewhere on the board
GND: C17.2, C18.2, C39.1, D60.1 (K), U10.16 (VSS), U10.33 (VSS(EP)); also elsewhere on the board
MOTOR_PYA_SWCLK: U10.24 (PA14/SWCLK); also elsewhere on the board
MOTOR_PYA_SWDIO: U10.23 (PA13/SWDIO); also elsewhere on the board
MOTOR_PY_NRST: C18.1, U10.4 (PF2/NRST); also elsewhere on the board
unnamed: D60.2 (A), R25.2
unnamed: R25.1, U10.10 (PA4/ADC_IN4)

Parts of its further copies:
C46, C48: 100nF; C_0402_1005Metric; LCSC C307331
C47: 10uF; C_0402_1005Metric; LCSC C15525
D61: LED_yellow; LED_0402_1005Metric; LCSC C130721
R28: 1K; R_0402_1005Metric; LCSC C11702
U14: PY32F030K28U6TR; VQFN-32-1EP_5x5mm_P0.5mm_EP3.5x3.5mm; LCSC C3018718

Connections of its further copies:
+3V3: C47.2, C48.1, U14.1 (VCC); also elsewhere on the board
/MotorSystem/MotorDriver-3/MOTOR_SIGNAL_1A: U14.26 (PB3); also elsewhere on the board
/MotorSystem/MotorDriver-3/MOTOR_SIGNAL_1B: U14.29 (PB6); also elsewhere on the board
/MotorSystem/MotorDriver-3/MOTOR_SIGNAL_2A: U14.5 (PF3); also elsewhere on the board
/MotorSystem/MotorDriver-3/MOTOR_SIGNAL_2B: U14.8 (PA2/ADC_IN2); also elsewhere on the board
/MotorSystem/MotorDriver-3/SENSEI_1: U14.6 (PA0/ADC_IN0); also elsewhere on the board
/MotorSystem/MotorDriver-3/SENSEI_2: U14.7 (PA1/ADC_IN1); also elsewhere on the board
/MotorSystem/MotorDriver-4/MOTOR_SIGNAL_1A: U14.11 (PA5/ADC_IN5); also elsewhere on the board
/MotorSystem/MotorDriver-4/MOTOR_SIGNAL_1B: U14.15 (PB1/ADC_IN9); also elsewhere on the board
/MotorSystem/MotorDriver-4/MOTOR_SIGNAL_2A: U14.18 (PA8); also elsewhere on the board
/MotorSystem/MotorDriver-4/MOTOR_SIGNAL_2B: U14.21 (PA11); also elsewhere on the board
/MotorSystem/MotorDriver-4/SENSEI_1: U14.13 (PA7/ADC_IN7); also elsewhere on the board
/MotorSystem/MotorDriver-4/SENSEI_2: U14.14 (PB0/ADC_IN8); also elsewhere on the board
E5A: U14.2 (PF0/OSC_IN); also elsewhere on the board
E5B: U14.3 (PF1/OSC_OUT); also elsewhere on the board
E6A: U14.25 (PA15); also elsewhere on the board
E6B: U14.30 (PB7); also elsewhere on the board
E7A: U14.20 (PA10); also elsewhere on the board
E7B: U14.22 (PA12); also elsewhere on the board
E8A: U14.17 (PB2); also elsewhere on the board
E8B: U14.19 (PA9); also elsewhere on the board
GND: C46.2, C47.1, C48.2, D61.1 (K), U14.16 (VSS), U14.33 (VSS(EP)); also elsewhere on the board
MOTOR_PYB_SWCLK: U14.24 (PA14/SWCLK); also elsewhere on the board
MOTOR_PYB_SWDIO: U14.23 (PA13/SWDIO); also elsewhere on the board
MOTOR_PY_NRST: C46.1, U14.4 (PF2/NRST); also elsewhere on the board
unnamed: D61.2 (A), R28.2
unnamed: R28.1, U14.10 (PA4/ADC_IN4)

Notes on the sheet:
locked

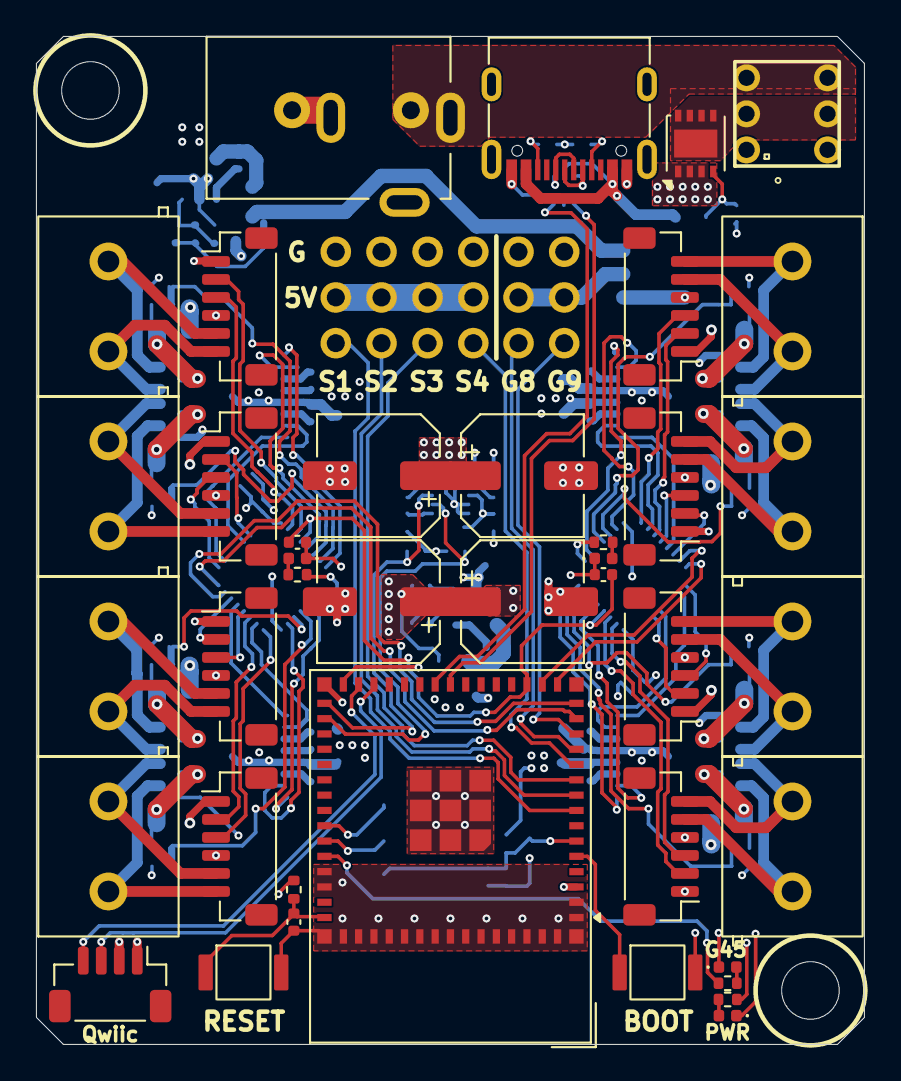
[picture p6: board NoU3.kicad_pcb from above]

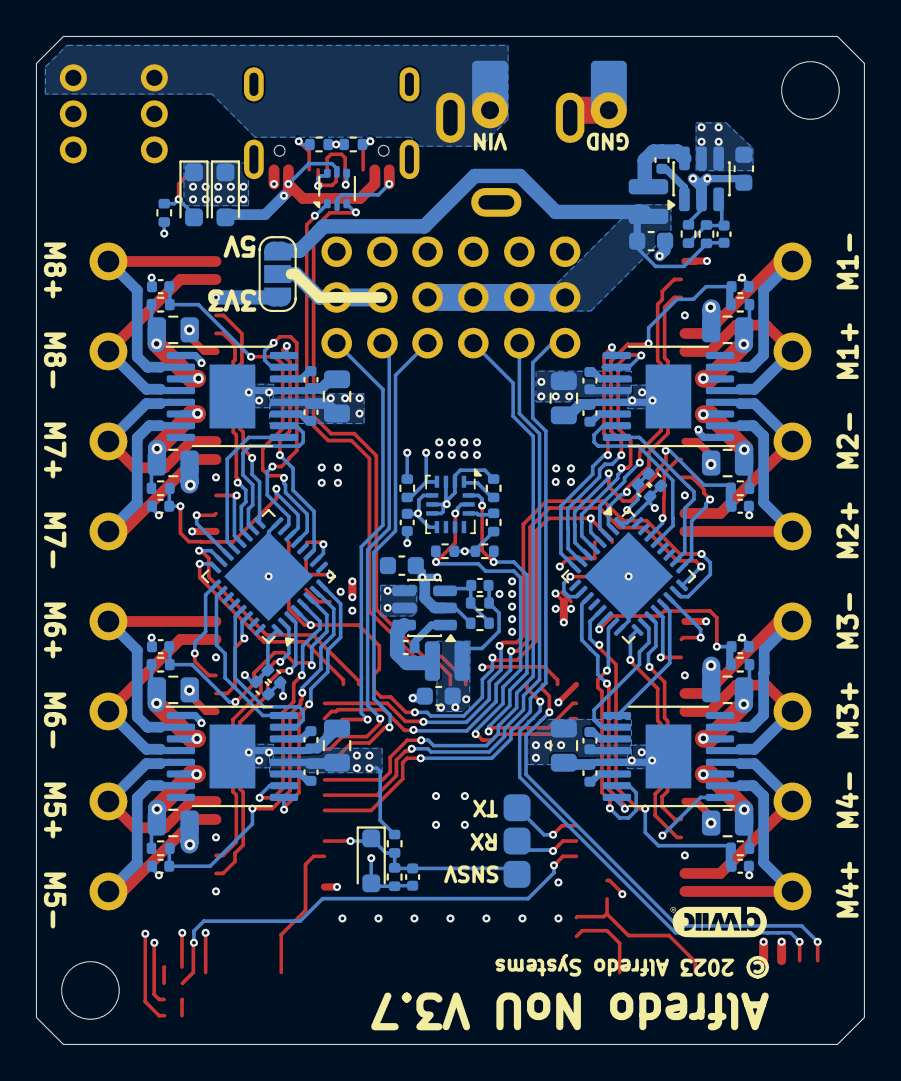
[picture p7: board NoU3.kicad_pcb from below]

Board: 4 copper layers, 46.0 x 56.0 mm, 134 parts (85 on the bottom side), 123 nets.

Other parts of the board:
H1, H2: (no value)
TAB1, TAB2, TAB3, TAB4: Tab
