AlfredoSystems/NoU3-Hardware/NoU3-Lite/NoU3-Lite.kicad_pcb

## KiCad design NoU3-Lite/NoU3-Lite.kicad_pcb (2024-08-16)

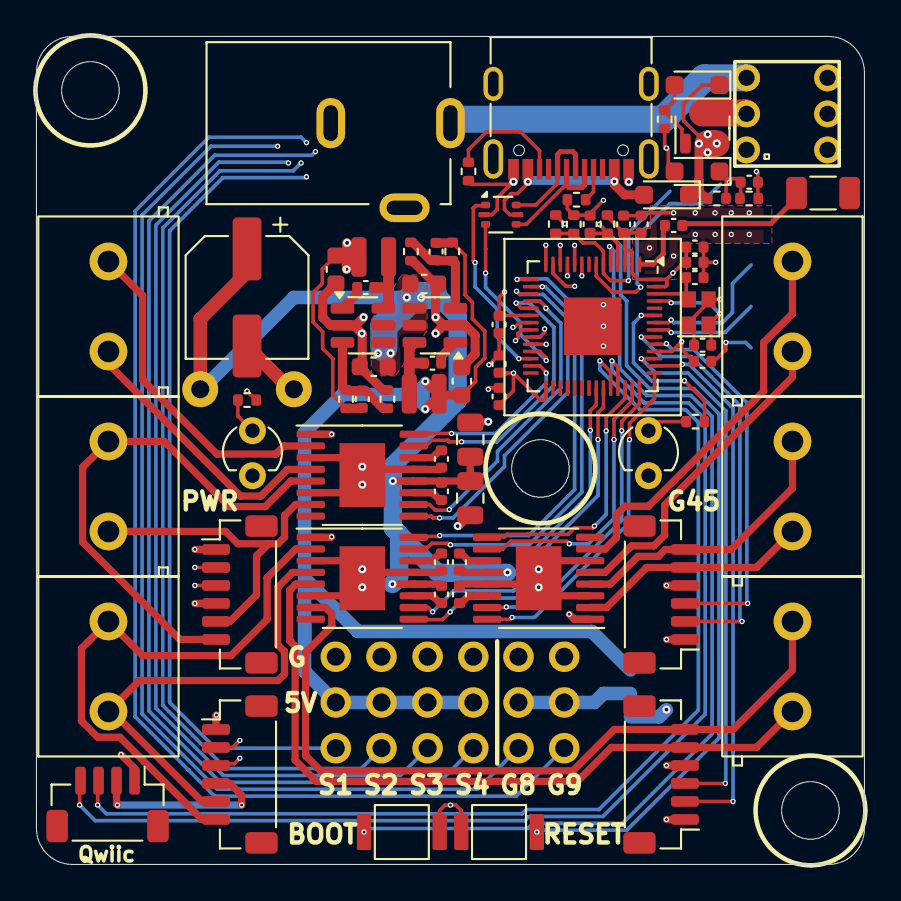
[picture p8: board NoU3-Lite.kicad_pcb from above]

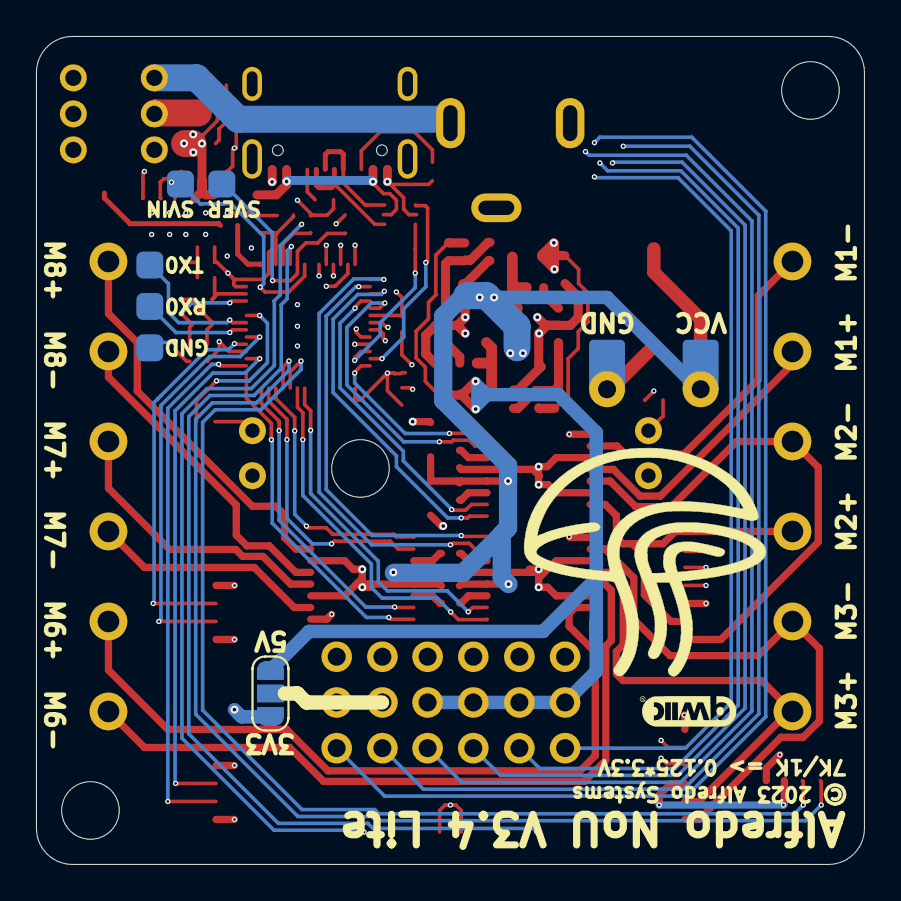
[picture p9: board NoU3-Lite.kicad_pcb from below]

Board: 4 copper layers, 46.0 x 46.0 mm, 92 parts (8 on the bottom side), 80 nets.

Parts:
C1, C15, C25, C26, C28, C29, C30: 100nF; C_0402_1005Metric
C3, C6, C9, C34: 10nF; C_0402_1005Metric
C4, C7, C10: 2.2uF; C_0402_1005Metric
C5, C8: 10uF; C_0805_2012Metric
C14: 100pF; C_0402_1005Metric
C16: CP_Elec_6.3x7.7
C21: 10uF; C_0402_1005Metric
C22, C23: 10uF,25V; C_0603_1608Metric
C24, C27, C31: 1uF; C_0402_1005Metric
C32, C33, C37, C38: 10pF; C_0402_1005Metric
C35, C36: 22uF, 6V3; C_0603_1608Metric
D1: Z5V6; D_SOD-323
D2: 1N5819; D_SOD-323
D3: Z3V3; D_SOD-323
D5: LED_blue; LED_3mm
D6: LED_green; LED_3mm
J1, J4, J7, J17: JST SR/SZ; JST_SH_1x06_Vertical
J2, J3, J5, J6, J8, J9: Screw_Terminal_01x02; TerminalBlock_Ningbo_2P_5mm
J14: RFANT3216120A5T; C_1206_3216Metric
J15: Barrel_Jack; DC-005C_1
J16: VIN; PinSocket_1x01_P2.54mm_Vertical
J18: GND; PinSocket_1x01_P2.54mm_Vertical
JP1: Jumper_3_Open; SolderJumper-3-Small
L1, L2: 4.7uH; LVF252A12
Q1: AO3401A; SOT-23-small
R5, R17, R18, R29: 1K; R_0402_1005Metric
R10: 10K; R_0402_1005Metric
R11: 68K; R_0402_1005Metric
R12, R26: 15K; R_0402_1005Metric
R13: 33K; R_0402_1005Metric
R14: 4K7; R_0402_1005Metric
R15, R16: 5.1K; R_0402_1005Metric
R27: 2K2; R_0402_1005Metric
R30: 6K8; R_0402_1005Metric
SW1: reset; Button_SKRKAEE020
SW2: boot; Button_SKRKAEE020
T1, T1#2, T1#3, T1#4: Tab
TP1: RX0; PogoPad1
TP2: TX0; PogoPad1
TP3: GND; PogoPad1
TP20: Svin; PogoPad1
TP21: Sver; PogoPad1
U1, U4, U5: HR8833
U2: ESP32-S3FN8; QFN-56-1EP_7x7mm_P0.4mm_EP3.2x3.2mm
U3: Crystal_ESP32; Crystal_SMD_2016-4Pin_2.0x1.6mm
U7, U18, U19: ServoPorts_2x3
U8: 5.8 ZSPT; XKB5858-Z-75
U9: USBLC6-2P6; SOT-666
U11: Qwiic1; JST_SH_BM04B-SRSS-TB_1x04-1MP_P1.00mm_Vertical
U15, U16: SY8113BADC; TSOT-23-6
U17: USB_C_Receptacle; USB_TYPE-C-31-M-12

Connections:
+3V3: C21.2, C24.2, C25.2, C26.2, C27.2, C30.2, C31.2, C32.1, C34.2, C35.1, J1.4, J4.4, J7.4, J17.4, JP1.1 (A), L1.2, R5.2, R11.1, R17.1, R30.2, U1.1 (nSLEEP), U2.2 (VDD3P3), U2.3 (VDD3P3), U2.20 (VDD3P3_RTC), U2.29 (VDDSPI), U2.46 (VDD3P3_CPU), U2.55 (VDDA), U2.56 (VDDA), U4.1 (nSLEEP), U5.1 (nSLEEP), U11.2 (3V3)
+5V: C33.1, C36.1, JP1.3 (B), L2.2, R13.1, U18.1 (PWR), U19.1 (PWR)
/MotorDriver-1/Aout1: J1.5, J2.2, U1.2 (AOUT1)
/MotorDriver-1/Aout2: J1.6, J2.1, U1.4 (AOUT2)
/MotorDriver-1/Bout1: J3.1, U1.7 (BOUT1)
/MotorDriver-1/Bout2: J3.2, U1.5 (BOUT2)
/MotorDriver-2/Aout1: J5.2, U4.2 (AOUT1)
/MotorDriver-2/Aout2: J5.1, U4.4 (AOUT2)
/MotorDriver-2/Bout1: J4.5, J6.1, U4.7 (BOUT1)
/MotorDriver-2/Bout2: J4.6, J6.2, U4.5 (BOUT2)
/MotorDriver-3/Aout1: J7.6, J8.2, U5.2 (AOUT1)
/MotorDriver-3/Aout2: J7.5, J8.1, U5.4 (AOUT2)
/VUSB: D2.2 (A), U9.5 (VBUS), U17.A4 (VBUS), U17.A9 (VBUS), U17.B4 (VBUS), U17.B9 (VBUS)
E2A: J4.3, U2.21 (XTAL32K_P)
E2B: J4.2, U2.22 (XTAL_32K_N)
E3A: J7.3, U2.23 (GPIO17/DAC_1)
E3B: J7.2, U2.24 (GPIO18/DAC_2)
E4A: J17.3, U2.45 (MTDO)
E4B: J17.2, U2.44 (MTCK)
E5A: J1.3, U2.47 (MTDI)
E5B: J1.2, U2.48 (MTMS)
E_D+: U2.26 (GPIO20), U9.1 (I/O1)
E_D-: U2.25 (GPIO19), U9.3 (I/O2)
GND: C1.2, C4.2, C5.2, C7.2, C8.2, C10.2, C15.2, C16.2, C21.1, C22.2, C23.2, C24.1, C25.1, C26.1, C27.1, C30.1, C31.1, C34.1, C35.2, C36.2, C37.2, C38.1, D3.2 (A), D5.1 (K), D6.1 (K), J1.1, J4.1, J7.1, J15.2, J17.1, J18.1, R10.2, R12.2, R14.2, R15.2, R16.1, R27.1, R29.1, SW1.2, SW2.2, TP3.1, U1.3 (AISEN), U1.6 (BISEN), U1.13 (GND), U1.17 (GND(PPAD)), U2.57 (EPAD), U3.2, U3.4, U4.3 (AISEN), U4.6 (BISEN), U4.13 (GND), U4.17 (GND(PPAD)), U5.3 (AISEN), U5.6 (BISEN), U5.13 (GND), U5.17 (GND(PPAD)), U7.2 (GND), U9.2 (GND), U11.1 (GND), U15.2 (GND), U16.2 (GND), U17.A1 (GND), U17.A12 (GND), U17.B1 (GND), U17.B12 (GND), U18.2 (GND), U19.2 (GND)
GPIO_MISC1: U2.13 (GPIO8), U7.3 (srv1)
GPIO_MISC2: U2.14 (GPIO9), U7.4 (srv2)
LED_MISC: R18.1, U2.51 (GPIO45)
M1A: U2.27 (GPIO21), U4.16 (AIN1)
M1B: U2.19 (GPIO14), U4.15 (AIN2)
M2A: U2.17 (GPIO12), U4.9 (BIN1)
M2B: U2.18 (GPIO13), U4.10 (BIN2)
M3A: U2.16 (GPIO11), U5.16 (AIN1)
M3B: U2.15 (GPIO10), U5.15 (AIN2)
M4A: U2.37 (SPICLK_P), U5.9 (BIN1)
M4B: U2.36 (SPICLK_N), U5.10 (BIN2)
M5A: U1.16 (AIN1), U2.43 (GPIO38)
M5B: U1.15 (AIN2), U2.42 (GPIO37)
M6A: U1.9 (BIN1), U2.40 (GPIO35)
M6B: U1.10 (BIN2), U2.41 (GPIO36)
MD4_B1: J9.1, J17.6, U5.7 (BOUT1)
MD4_B2: J9.2, J17.5, U5.5 (BOUT2)
unnamed: D1.2 (A), Q1.1 (G), R10.1
unnamed: D5.2 (A), R17.2
unnamed: D6.2 (A), R18.2
unnamed: C14.1, J14.1 (FEED)
unnamed: J15.1, U8.3
unnamed: JP1.2 (C), U7.1 (PWR)
unnamed: Q1.3 (D), U8.2
unnamed: C3.2, U1.11 (VCP)
unnamed: C4.1, U1.14 (VINT)
unnamed: C1.1, R5.1, SW1.1, U2.4 (CHIP_PU)
unnamed: SW2.1, U2.5 (GPIO0)
unnamed: C14.2, U2.1 (LNA_IN)
unnamed: TP2.1, U2.50 (U0RXD)
unnamed: TP1.1, U2.49 (U0TXD)
unnamed: C38.2, U2.53 (XTAL_N), U3.1
unnamed: C37.1, U2.54 (XTAL_P), U3.3
unnamed: C6.2, U4.11 (VCP)
unnamed: C7.1, U4.14 (VINT)
unnamed: C9.2, U5.11 (VCP)
unnamed: C10.1, U5.14 (VINT)
unnamed: C28.1, U15.1 (BS)
unnamed: C32.2, R11.2, R12.1, U15.3 (FB)
unnamed: C28.2, L1.1, U15.6 (LX)
unnamed: C29.1, U16.1 (BS)
unnamed: C33.2, R13.2, R14.1, U16.3 (FB)
unnamed: C29.2, L2.1, U16.6 (LX)
unnamed: R15.1, U17.A5 (CC1)
unnamed: R16.2, U17.B5 (CC2)
unnamed: U9.6 (I/O1), U17.A6 (D+), U17.B6 (D+)
unnamed: U9.4 (I/O2), U17.A7 (D-), U17.B7 (D-)
Q_SCL: U2.39 (GPIO34), U11.4 (SCL)
Q_SDA: U2.38 (GPIO33), U11.3 (SDA)
SNS_VER: R29.2, R30.1, TP21.1, U2.6 (GPIO1)
SNS_VIN: C15.1, D3.1 (K), R26.1, R27.2, TP20.1, U2.7 (GPIO2)
SRV1: U2.9 (GPIO4), U18.3 (srv1)
SRV2: U2.10 (GPIO5), U18.4 (srv2)
SRV3: U2.11 (GPIO6), U19.3 (srv1)
SRV4: U2.12 (GPIO7), U19.4 (srv2)
VCC: C3.1, C5.1, C6.1, C8.1, C9.1, C16.1, C22.1, C23.1, D1.1 (K), D2.1 (K), J16.1, Q1.2 (S), R26.2, U1.12 (VM), U4.12 (VM), U5.12 (VM), U15.4 (EN), U15.5 (IN), U16.4 (EN), U16.5 (IN)
