AlfredoSystems/NoU3-Hardware/(notices)

Notices in the files:
NoU3-Lite/NoU3-Lite.kicad_pcb:
© 2023 Alfredo Systems
